thejmp/ECU/Dash/dash lights/Engine Lights.jpg

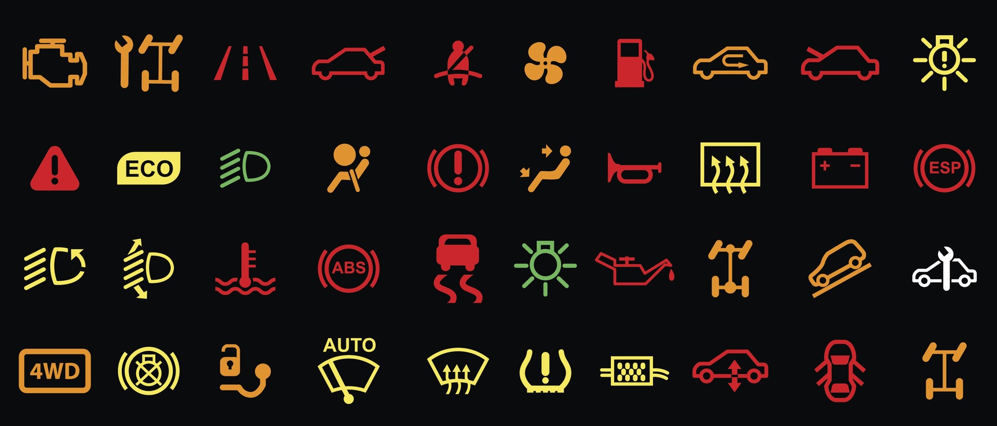
Dash/dash lights/Engine Lights.jpg
