thejmp/ECU/Dash/dash lights/gas.jpg

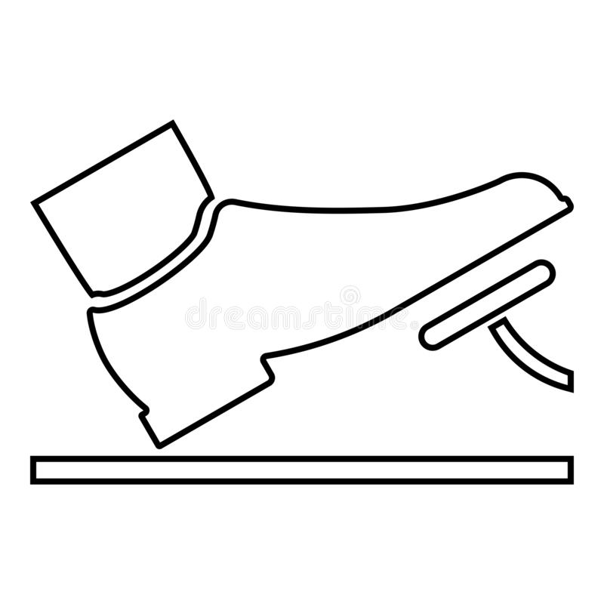
Dash/dash lights/gas.jpg
