thejmp/ECU/Dash/dash lights/temp.jpg

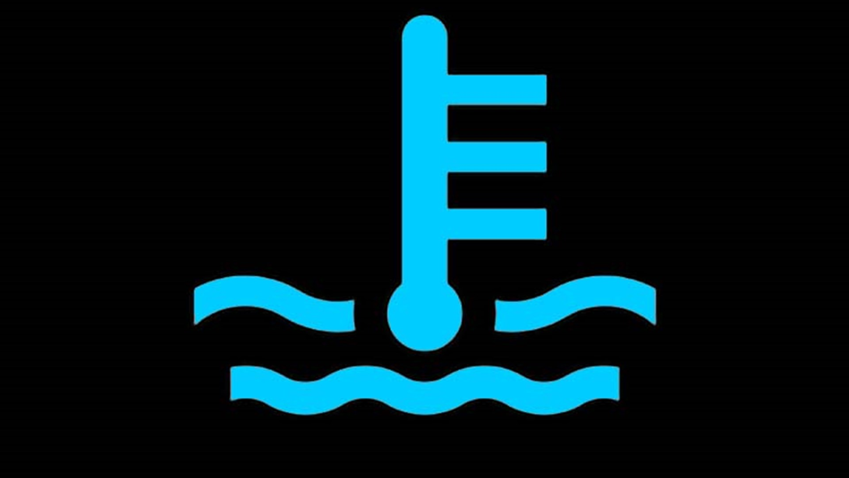
Dash/dash lights/temp.jpg
