thejmp/ECU/Dash/dash lights/temp.png

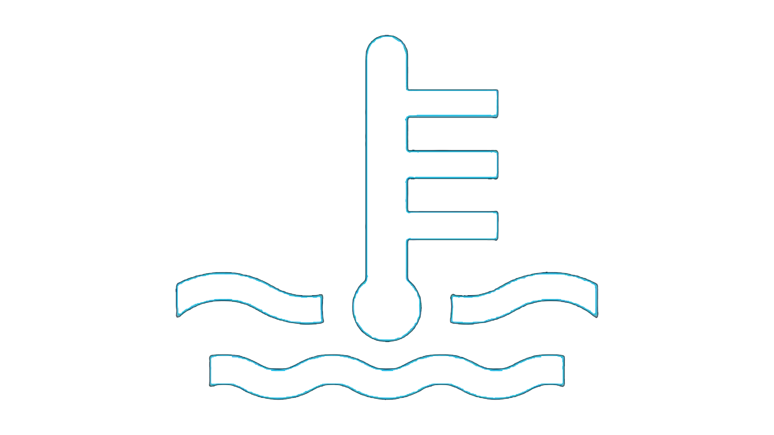
Dash/dash lights/temp.png
