thejmp/ECU/Dash/dash.png

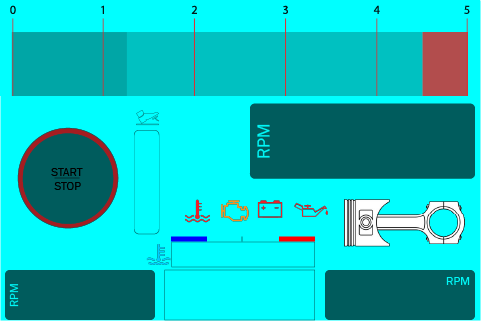
Dash/dash.png
