thejmp/ECU/Images/piston.png

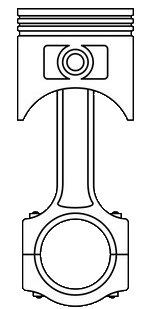
Images/piston.png
