thejmp/ECU/PCB & schematic/PCB_PCB_2020-06-12_10-47-50_2020-06-15_18-39-56.png

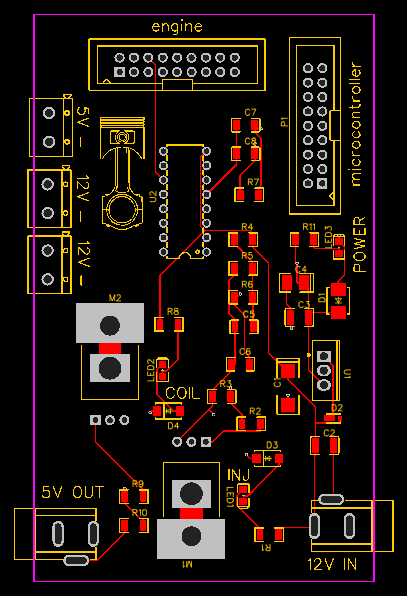
PCB & schematic/PCB_PCB_2020-06-12_10-47-50_2020-06-15_18-39-56.png
