thejmp/ECU/PCB & schematic/BOM_ECUs_2020-06-15_18-41-51.csv

ID | Name | Designator | Footprint | Quantity | Manufacturer Part | Manufacturer | Supplier | Supplier Part | LCSC Assembly
1 | LED-0805_R | LED1,LED2 | LED0805_RED | 2 | 17-21SURC/S530-A3/TR8 | EVERLIGHT(台湾亿光) |  | C72037
2 | 1SMB5919BT3G | D1 | SMB_L4.6-W3.6-LS5.3-RD | 1 | 1SMB5919BT3G | ON Semicon | LCSC | C70260 | Yes
3 | GF1G-E3/67A | D3,D4 | DO-214BA_L4.8-W2.9-LS5.3-RD | 2 | GF1G-E3/67A | VISHAY | LCSC | C145458 | Yes
4 | HDR-IDC-2.54-2X9P | P1,P2 | IDC-TH_18P-P2.54-V-R2-C9-S2.54 | 2 | 2X9 2.54mm IDC Box | BOOMELE | LCSC | C11216
5 | L293D | U2 | DIP-16_L20.0-W6.4-P2.54-LS7.6-BL | 1 | L293D | STMicroelectronics | LCSC | C12340
6 | LM2940T-5.0 | U1 | TO-220-3_L10.0-W4.5-P2.54-L | 1 | LM2940T-5.0 | HGSEMI | LCSC | C434573
7 | JL301-50002U02 | U3,U4,U5 | CONN-TH_2P-P2.54_JL301-50002U02 | 3 | JL301-50002U02 | JILN | LCSC | C395214
8 | dc-005 5.5-2.0 | DC1,DC2 | DC-IN-TH_DC005 | 2 | - | Shenzhen Cankemeng | LCSC | C132516
9 | 10uF35v | C1 | CASE-C_6032 | 1 | T491C106K035AT | KEMET | Mouser | 80-T491C106K035
10 | 0.1uF50v | C2,C3 | C1210 | 2 | VJ1210Y104MXAAT | Vishay / Vitramon | Mouser | 77-VJ1210Y104MXAAT
11 | 0.1u | C5,C7,C8 | C1206 | 3 | T491A104M050AT | KEMET | Mouser | 80-T491A104M050AT
12 | 0.22u | C6 | C1206 | 1 | TPSA224K050R7000 | AVX | Mouser | 581-TPSA224K050R7000
13 | 47u10v | C4 | CASE-B_3528 | 1 | T491B476K006AT | KEMET | Mouser | 80-T491B476K006
14 | STP62NS04Z | M1,M2 | STP62NS04Z_HORIZ_HAND_SOLDER | 2 | STP62NS04Z | ST | RS-Online | 761-0152
15 | LED-0805_G | LED3 | LED0805_GREEN | 1 | NCD0805G1 | 国星光电 |  | C84260
16 | MSS1P3-M3/89A | D2 | MICROSMP_L2.2-W1.3-LS2.5-RD | 1 | MSS1P3-M3/89A | Vishay Intertech | LCSC | C111315
17 | 680 | R11,R1,R8 | R1206 | 3 | RT1206FRE07680RL | Yageo | Mouser | 603-RT1206FRE07680RL
18 | 1k | R2,R9,R5,R7 | R1206 | 4 | RC1206FR-071KL | YAGEO | LCSC | C131398
19 | 100k | R3,R10 | R1206 | 2 | RC1206FR-07100KL | YAGEO | LCSC | C137393
20 | 3.9k | R4 | R1206 | 1 | RC1206FR-073R9L | YAGEO | LCSC | C137280
21 | 470 | R6 | R1206 | 1 | RC1206FR-07470RL | YAGEO | LCSC | C114945
