thejmp/ECU/(list of files, drawings)

Other design files:
PCB & schematic/PCB_2020-06-12_10-47-50.json
