thejmp/ECU/(commit log)

2020-06-16 excel parts
    [sinor project.csv, sinor project.xlsx]
2020-06-16 pcb and markdown
    [PCB_2020-06-12_10-47-50.json, sinor project.csv, sinor project.xlsx]
2020-06-16 pcb img
2020-06-25 timer finshed
